Rosh264/Arduino-Based-quadruped-with-12-servo-driven/spider_circuit_with_esp32_cam_clean.png

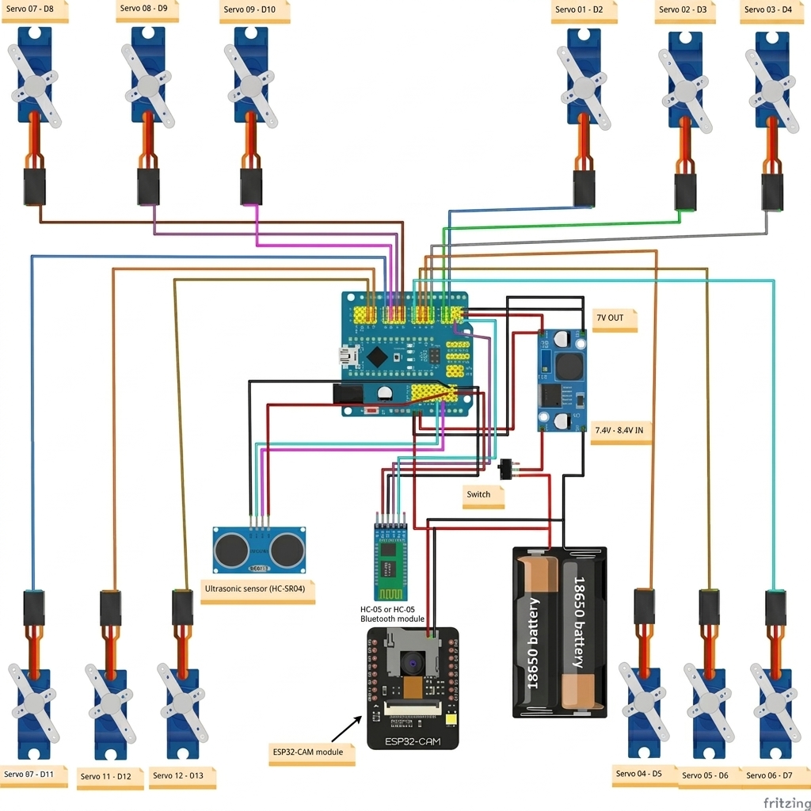
spider_circuit_with_esp32_cam_clean.png
