Rosh264/Arduino-Based-quadruped-with-12-servo-driven/WhatsApp Image 2026-06-17 at 16.40.53.jpeg

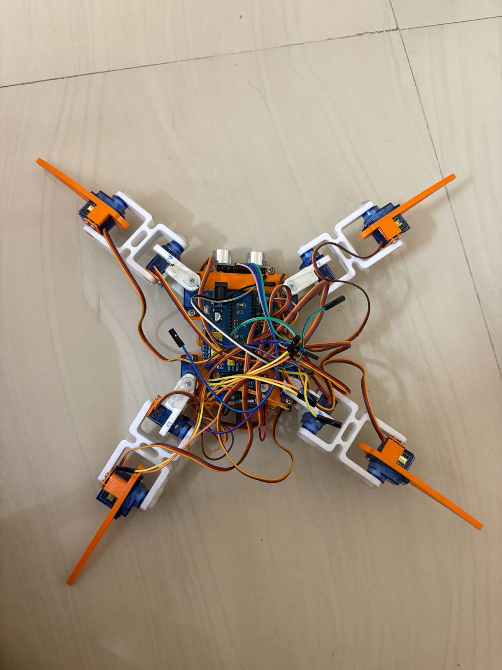
WhatsApp Image 2026-06-17 at 16.40.53.jpeg
